brucemack/tt07-sb-mixer/verilog/gl/quadrature_divider.v

module quadrature_divider (VGND,
    VPWR,
    clk,
    n_rst,
    out_i,
    out_q);
 input VGND;
 input VPWR;
 input clk;
 input n_rst;
 output out_i;
 output out_q;

 wire _0_;
 wire \f0.d ;
 wire \f0.q ;
 wire \f1.d ;
 wire \f1.q ;
 wire net1;
 wire net2;

 sky130_ef_sc_hd__decap_12 FILLER_0_0_15 (.VGND(VGND),
    .VNB(VGND),
    .VPB(VPWR),
    .VPWR(VPWR));
 sky130_fd_sc_hd__fill_1 FILLER_0_0_27 (.VGND(VGND),
    .VNB(VGND),
    .VPB(VPWR),
    .VPWR(VPWR));
 sky130_ef_sc_hd__decap_12 FILLER_0_0_29 (.VGND(VGND),
    .VNB(VGND),
    .VPB(VPWR),
    .VPWR(VPWR));
 sky130_ef_sc_hd__decap_12 FILLER_0_0_3 (.VGND(VGND),
    .VNB(VGND),
    .VPB(VPWR),
    .VPWR(VPWR));
 sky130_ef_sc_hd__decap_12 FILLER_0_0_41 (.VGND(VGND),
    .VNB(VGND),
    .VPB(VPWR),
    .VPWR(VPWR));
 sky130_fd_sc_hd__decap_3 FILLER_0_0_53 (.VGND(VGND),
    .VNB(VGND),
    .VPB(VPWR),
    .VPWR(VPWR));
 sky130_ef_sc_hd__decap_12 FILLER_0_0_57 (.VGND(VGND),
    .VNB(VGND),
    .VPB(VPWR),
    .VPWR(VPWR));
 sky130_fd_sc_hd__fill_2 FILLER_0_0_69 (.VGND(VGND),
    .VNB(VGND),
    .VPB(VPWR),
    .VPWR(VPWR));
 sky130_ef_sc_hd__decap_12 FILLER_0_10_15 (.VGND(VGND),
    .VNB(VGND),
    .VPB(VPWR),
    .VPWR(VPWR));
 sky130_fd_sc_hd__fill_1 FILLER_0_10_27 (.VGND(VGND),
    .VNB(VGND),
    .VPB(VPWR),
    .VPWR(VPWR));
 sky130_fd_sc_hd__fill_1 FILLER_0_10_29 (.VGND(VGND),
    .VNB(VGND),
    .VPB(VPWR),
    .VPWR(VPWR));
 sky130_ef_sc_hd__decap_12 FILLER_0_10_3 (.VGND(VGND),
    .VNB(VGND),
    .VPB(VPWR),
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
    .Q(\f1.q ));
 sky130_fd_sc_hd__dlygate4sd3_1 hold1 (.A(\f0.q ),
    .VGND(VGND),
    .VNB(VGND),
    .VPB(VPWR),
    .VPWR(VPWR),
    .X(net2));
 sky130_fd_sc_hd__buf_1 input1 (.A(n_rst),
    .VGND(VGND),
    .VNB(VGND),
    .VPB(VPWR),
    .VPWR(VPWR),
    .X(net1));
endmodule
