brucemack/tt07-sb-mixer/(commit log)

2024-05-13 Initial schematic
    [sb_mixer.sch]
2024-05-13 Test bench simulation started
    [sb_mixer.sch, testbench.sch]
2024-05-13 Initial simulation is working
    [sb_mixer.sch, testbench.sch]
2024-05-13 Initial spectrum
    [testbench.sch]
2024-05-15 Working on initial layout
    [sb_mixer.sch, testbench.sch]
2024-05-15 Added side taps for inverters
    [sb_mixer.sch]
2024-05-23 Working on double-balanced mixer
    [db_mixer.sch]
2024-05-23 Working on DB mixer
    [db_mixer.sch, testbench_db.sch]
2024-05-23 Added traces for DBM
2024-05-23 Simulation working
    [testbench_db.sch]
2024-05-23 Moved to a single-ended RF input
    [db_mixer.sch, testbench_db.sch]
2024-05-24 Getting ready to start layout
    [db_mixer.sch]
2024-05-25 Cleaned up metal4 rail routing - no longer connected directly to ports
2024-05-25 About to do some rework to add a diode
2024-05-25 Working on adding a diode to LOIN
    [db_mixer.sch]
2024-05-25 Resolved antenna violation
    [db_mixer.sch]
2024-05-25 Extracted simulation, fixed missing file
    [testbench_db2.sch]
2024-05-25 Fixing pin issues
2024-05-29 Adjustments for sim
    [testbench_db2.sch]
2024-05-30 Adding files needed to create digital blog
    [pin_order.cfg]
